hahhen/gbczero/gbczero/gbczero.kicad_pcb

## KiCad design gbczero/gbczero.kicad_pcb (2025-12-26)

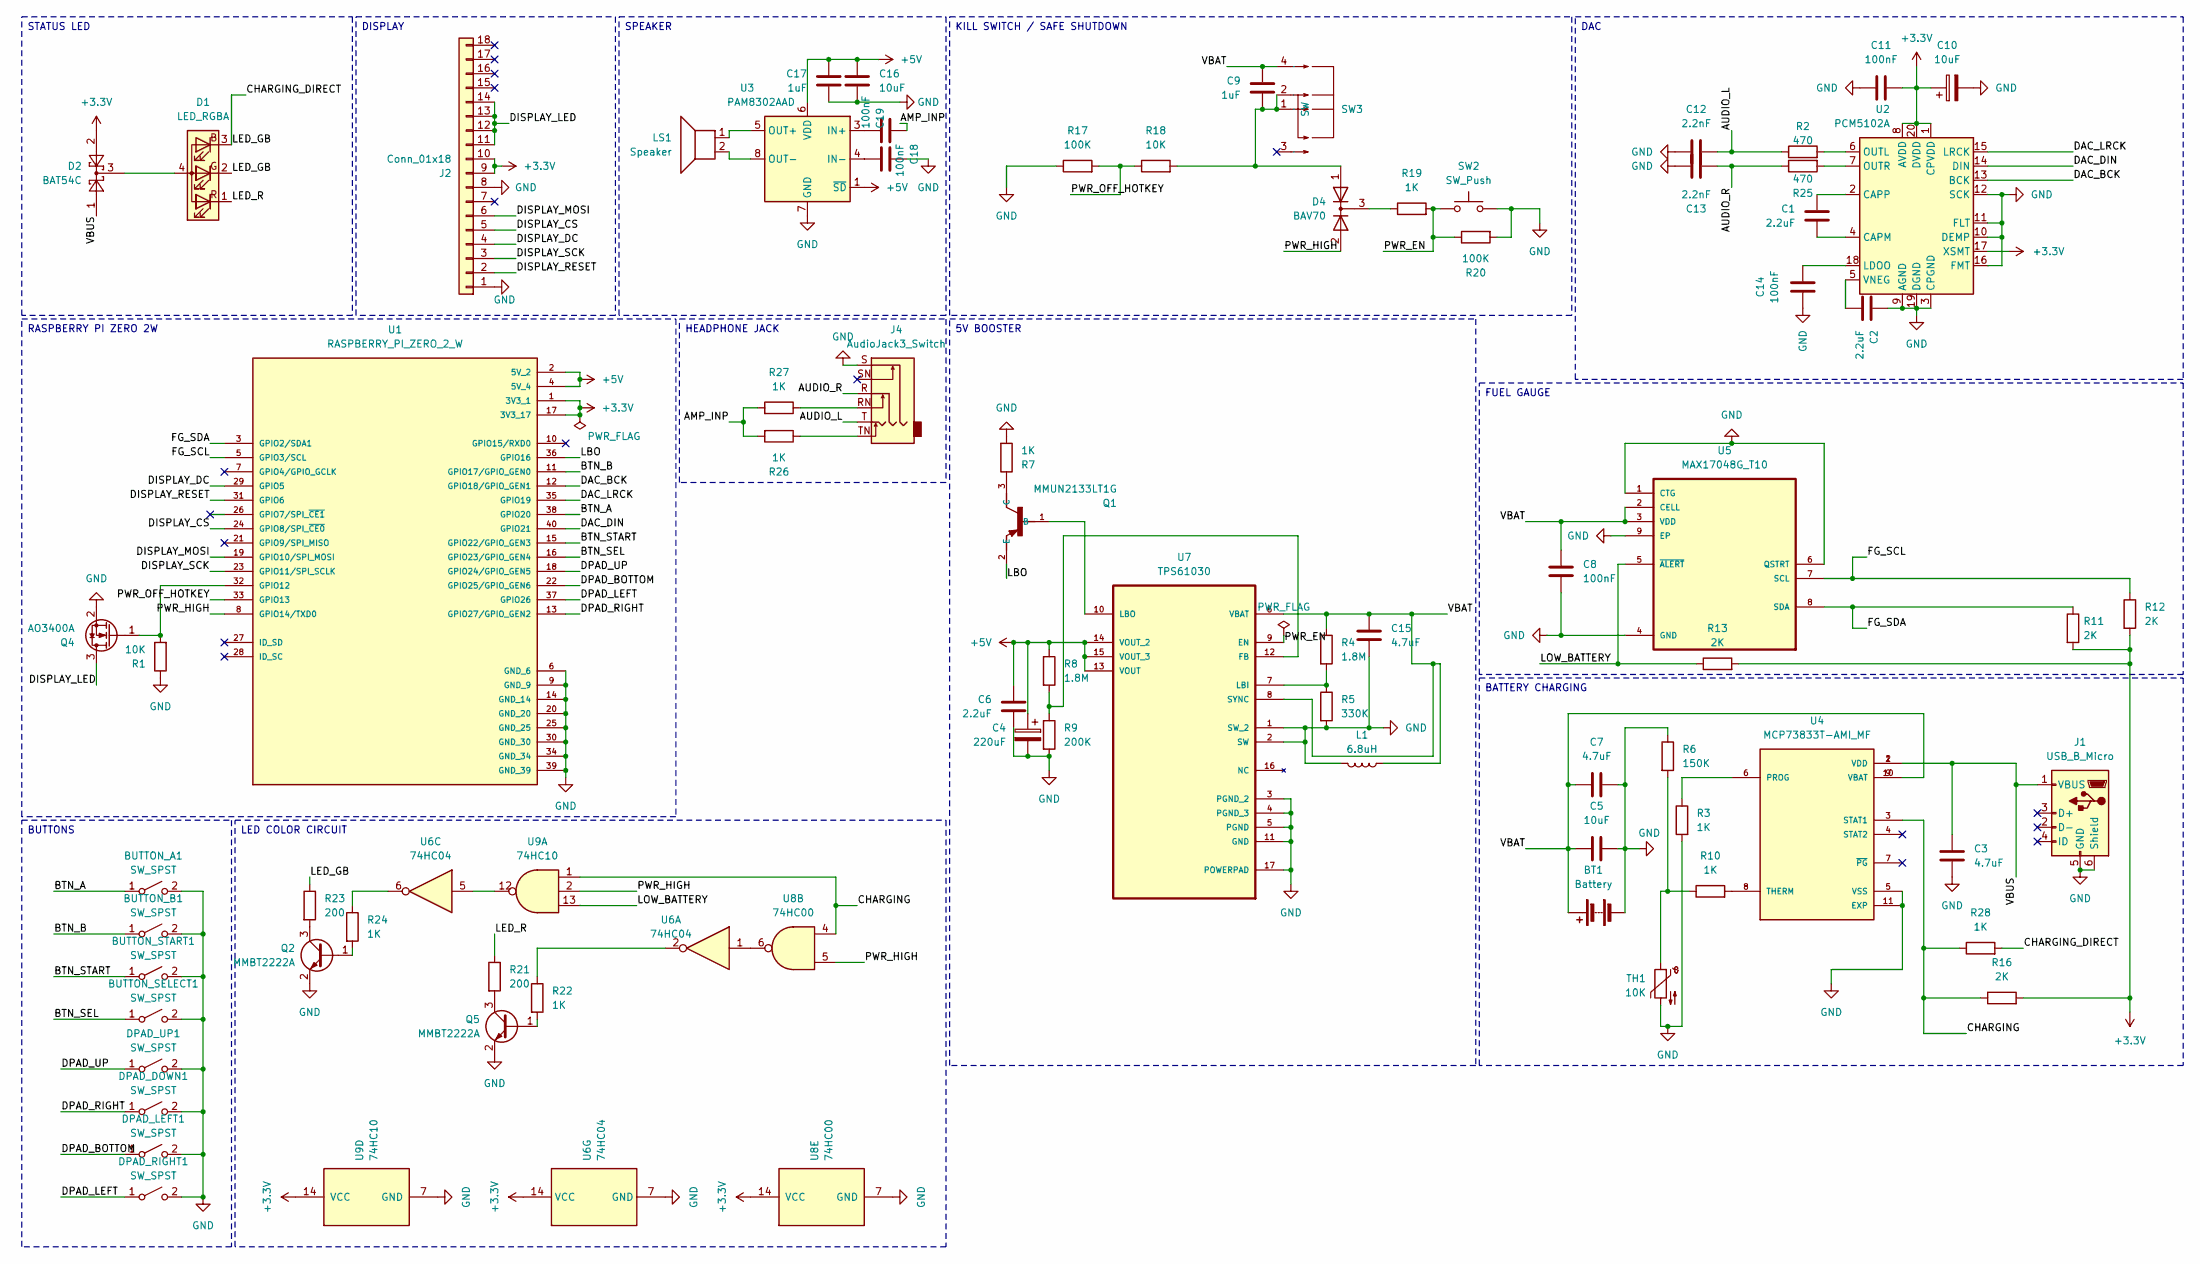
[picture p1: schematic gbczero.kicad_sch, Gameboy Color Zero]

Parts:
BT1: Battery; JST_PH_S2B-PH-K_1x02_P2.00mm_Horizontal
BUTTON_A1: SW_SPST; GameBoy-DMG-BTN
BUTTON_B1: SW_SPST; GameBoy-DMG-BTN
BUTTON_SELECT1: SW_SPST; GameBoy-DMG-START-SEL
BUTTON_START1: SW_SPST; GameBoy-DMG-START-SEL
C1, C2, C6: 2.2uF; C_0603_1608Metric
C3, C7, C15: 4.7uF; C_0603_1608Metric
C4: 220uF; CP_EIA-7343-31_Kemet-D
C5, C16: 10uF; C_0603_1608Metric
C8, C11, C14, C18, C19: 100nF; C_0603_1608Metric
C9, C17: 1uF; C_0603_1608Metric
C10: 10uF; CP_EIA-3216-18_Kemet-A
C12, C13: 2.2nF; C_0603_1608Metric
D1: LED_RGBA; LED_D5.0mm-4_RGB
D2: BAT54C; SOT-23
D4: BAV70; SOT-23
DPAD_DOWN1: SW_SPST; GameBoy-DMG-BTN
DPAD_LEFT1: SW_SPST; GameBoy-DMG-BTN
DPAD_RIGHT1: SW_SPST; GameBoy-DMG-BTN
DPAD_UP1: SW_SPST; GameBoy-DMG-BTN
J1: USB_B_Micro; USB_Micro-B_Molex_47346-0001
J2: Conn_01x18; Hirose_FH12-18S-0.5SH_1x18-1MP_P0.50mm_Horizontal
J4: AudioJack3_Switch; Jack_3.5mm_CUI_SJ1-3523N_Horizontal
L1: 6.8uH; L_6.3x6.3_H3
LS1: Speaker; PinHeader_1x02_P2.54mm_Vertical
Q1: MMUN2133LT1G; SOT95P240X111-3N
Q2, Q5: MMBT2222A; SOT-23
Q4: AO3400A; SOT-23
R1, R18: 10K; R_0603_1608Metric
R2, R25: 470; R_0603_1608Metric
R3, R7, R10, R19, R22, R24, R26, R27, R28: 1K; R_0603_1608Metric
R4, R8: 1.8M; R_0603_1608Metric
R5: 330K; R_0603_1608Metric
R6: 150K; R_0603_1608Metric
R9: 200K; R_0603_1608Metric
R11, R12, R13, R16: 2K; R_0603_1608Metric
R17, R20: 100K; R_0603_1608Metric
R21, R23: 200; R_0603_1608Metric
SW2: SW_Push; SW_Push_1P1T_XKB_TS-1187A
SW3: SW; SW-SMD_4P-P1.50_L3.6-W11.3; Manufacturer Part SK-1391L-2; LCSC Part Name 卧贴双档 滑动开关
TH1: 10K; R_0603_1608Metric
U1: RASPBERRY_PI_ZERO_2_W; MODULE_RASPBERRY_PI_ZERO_2_W; PARTREV April 2024
U2: PCM5102A; TSSOP-20_4.4x6.5mm_P0.65mm
U3: PAM8302AAD; SOIC-8_3.9x4.9mm_P1.27mm
U4: MCP73833T-AMI_MF; SON50P300X300X100-11N
U5: MAX17048G_T10; SON50P200X200X80-9N
U6: 74HC04; SOIC-14_3.9x8.7mm_P1.27mm
U7: TPS61030; SOP65P640X120-17N; MPN TPS61030
U8: 74HC00; SOIC-14_3.9x8.7mm_P1.27mm
U9: 74HC10; SOIC-14_3.9x8.7mm_P1.27mm

Connections:
+3.3V: C10.1, C11.1, D2.2, J2.9, J2.10, R11.2, R12.2, R13.2, R16.2, U1.1 (3V3_1), U1.17 (3V3_17), U2.1 (CPVDD), U2.8 (AVDD), U2.17 (XSMT), U2.20 (DVDD), U6.14 (VCC), U8.14 (VCC), U9.14 (VCC)
+5V: C4.1, C6.1, C16.1, C17.1, R8.1, U1.2 (5V_2), U1.4 (5V_4), U3.1 (~SD), U3.6 (VDD), U7.13 (VOUT), U7.14 (VOUT_2), U7.15 (VOUT_3)
/AMP_INP: C19.1, R26.2, R27.2
/AUDIO_L: C12.1, J4.T, R2.1
/AUDIO_R: C13.1, J4.R, R25.1
/BTN_A: BUTTON_A1.1 (A), U1.38 (GPIO20)
/BTN_B: BUTTON_B1.1 (A), U1.11 (GPIO17/GPIO_GEN0)
/BTN_SEL: BUTTON_SELECT1.1 (A), U1.16 (GPIO23/GPIO_GEN4)
/BTN_START: BUTTON_START1.1 (A), U1.15 (GPIO22/GPIO_GEN3)
/CHARGING: R16.1, R28.1, U4.3 (STAT1), U8.4, U9.1
/CHARGING_DIRECT: D1.2 (GK), D1.3 (BK), R23.1, R28.2
/DAC_BCK: U1.12 (GPIO18/GPIO_GEN1), U2.13 (BCK)
/DAC_DIN: U1.40 (GPIO21), U2.14 (DIN)
/DAC_LRCK: U1.35 (GPIO19), U2.15 (LRCK)
/DISPLAY_CS: J2.5, U1.24 (GPIO8/SPI_~CE0)
/DISPLAY_DC: J2.4, U1.29 (GPIO5)
/DISPLAY_LED: J2.11, J2.12, J2.13, J2.14, Q4.3 (D)
/DISPLAY_MOSI: J2.6, U1.19 (GPIO10/SPI_MOSI)
/DISPLAY_RESET: J2.2, U1.31 (GPIO6)
/DISPLAY_SCK: J2.3, U1.23 (GPIO11/SPI_SCLK)
/DPAD_BOTTOM: DPAD_LEFT1.1 (A), U1.22 (GPIO25/GPIO_GEN6)
/DPAD_LEFT: DPAD_RIGHT1.1 (A), U1.37 (GPIO26)
/DPAD_RIGHT: DPAD_DOWN1.1 (A), U1.13 (GPIO27/GPIO_GEN2)
/DPAD_UP: DPAD_UP1.1 (A), U1.18 (GPIO24/GPIO_GEN5)
/FG_SCL: R12.1, U1.5 (GPIO3/SCL), U5.7 (SCL)
/FG_SDA: R11.1, U1.3 (GPIO2/SDA1), U5.8 (SDA)
/LBO: Q1.2 (E), U1.36 (GPIO16)
/LED_R: D1.1 (RK), R21.1
/LOW_BATTERY: R13.1, U5.5 (~ALERT), U9.13
/PWR_EN: R19.2, R20.1, SW2.1, U7.9 (EN)
/PWR_HIGH: D4.2 (A), U1.8 (GPIO14/TXD0), U8.5, U9.2
/PWR_OFF_HOTKEY: R17.2, R18.1, U1.33 (GPIO13)
/VBAT: BT1.1 (+), C5.2, C7.2, C8.1, C9.1, C15.1, L1.1, R4.1, SW3.4, U4.9 (VBAT), U4.10 (VBAT), U5.2 (CELL), U5.3 (VDD), U7.6 (VBAT), U7.8 (SYNC)
/VBUS: C3.1, D2.1, J1.1 (VBUS), U4.1 (VDD), U4.2 (VDD)
GND: BT1.2 (-), BUTTON_A1.2 (B), BUTTON_B1.2 (B), BUTTON_SELECT1.2 (B), BUTTON_START1.2 (B), C2.1, C3.2, C4.2, C5.1, C6.2, C7.1, C8.2, C10.2, C11.2, C12.2, C13.2, C14.2, C15.2, C16.2, C17.2, C18.1, DPAD_DOWN1.2 (B), DPAD_LEFT1.2 (B), DPAD_RIGHT1.2 (B), DPAD_UP1.2 (B), J1.5 (GND), J1.6 (Shield), J2.1, J2.8, J4.S, L1.2, Q2.2 (E), Q4.2 (S), Q5.2 (E), R1.1, R3.2, R5.2, R6.1, R7.2, R9.2, R17.1, R20.2, SW2.2, TH1.2, U1.6 (GND_6), U1.9 (GND_9), U1.14 (GND_14), U1.20 (GND_20), U1.25 (GND_25), U1.30 (GND_30), U1.34 (GND_34), U1.39 (GND_39), U2.3 (CPGND), U2.9 (AGND), U2.10 (DEMP), U2.11 (FLT), U2.12 (SCK), U2.16 (FMT), U2.19 (DGND), U3.7 (GND), U4.5 (VSS), U4.11 (EXP), U5.1 (CTG), U5.4 (GND), U5.6 (QSTRT), U5.9 (EP), U6.7 (GND), U7.1 (SW_2), U7.2 (SW), U7.3 (PGND_2), U7.4 (PGND_3), U7.5 (PGND), U7.11 (GND), U7.17 (POWERPAD), U8.7 (GND), U9.7 (GND)
unnamed: C9.2, D4.1 (A), R18.2, SW3.1, SW3.2
unnamed: D1.4 (A), D2.3
unnamed: D4.3 (K), R19.1
unnamed: J4.RN, R27.1
unnamed: J4.TN, R26.1
unnamed: Q1.1 (B), U7.10 (LBO)
unnamed: Q1.3 (C), R7.1
unnamed: Q2.1 (B), R24.2
unnamed: Q2.3 (C), R23.2
unnamed: Q4.1 (G), R1.2, U1.32 (GPIO12)
unnamed: Q5.1 (B), R22.2
unnamed: Q5.3 (C), R21.2
unnamed: R6.2, R10.1, TH1.1
unnamed: R22.1, U6.2
unnamed: R24.1, U6.6
unnamed: C1.2, U2.4 (CAPM)
unnamed: C1.1, U2.2 (CAPP)
unnamed: C14.1, U2.18 (LDOO)
unnamed: R2.2, U2.6 (OUTL)
unnamed: R25.2, U2.7 (OUTR)
unnamed: C2.2, U2.5 (VNEG)
unnamed: C19.2, U3.3 (IN+)
unnamed: C18.2, U3.4 (IN-)
unnamed: LS1.1, U3.5 (OUT+)
unnamed: LS1.2, U3.8 (OUT-)
unnamed: R3.1, U4.6 (PROG)
unnamed: R10.2, U4.8 (THERM)
unnamed: U6.1, U8.6
unnamed: U6.5, U9.12
unnamed: R8.2, R9.1, U7.12 (FB)
unnamed: R4.2, R5.1, U7.7 (LBI)

Notes on the sheet:
BATTERY CHARGING
FUEL GAUGE
SPEAKER
BUTTONS
RASPBERRY PI ZERO 2W
DAC
5V BOOSTER
HEADPHONE JACK
STATUS LED
KILL SWITCH / SAFE SHUTDOWN
LED COLOR CIRCUIT
DISPLAY

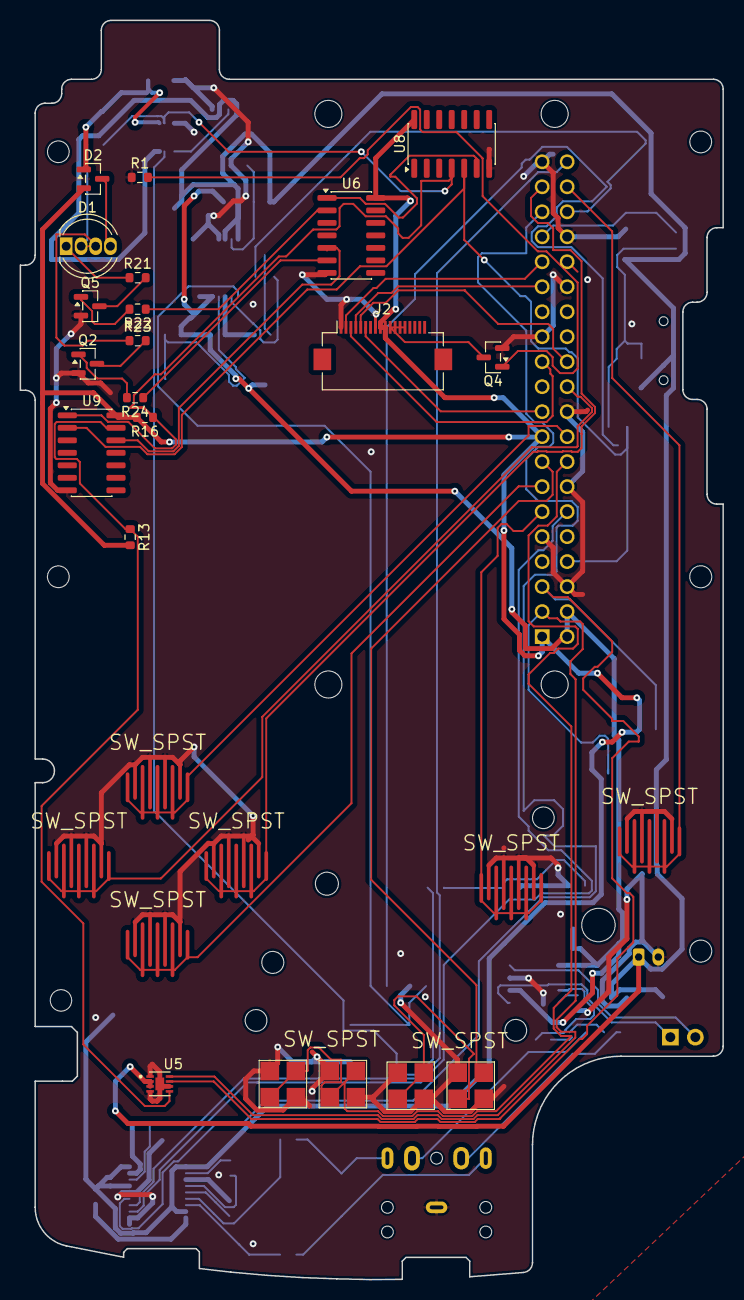
[picture p2: board gbczero.kicad_pcb from above]

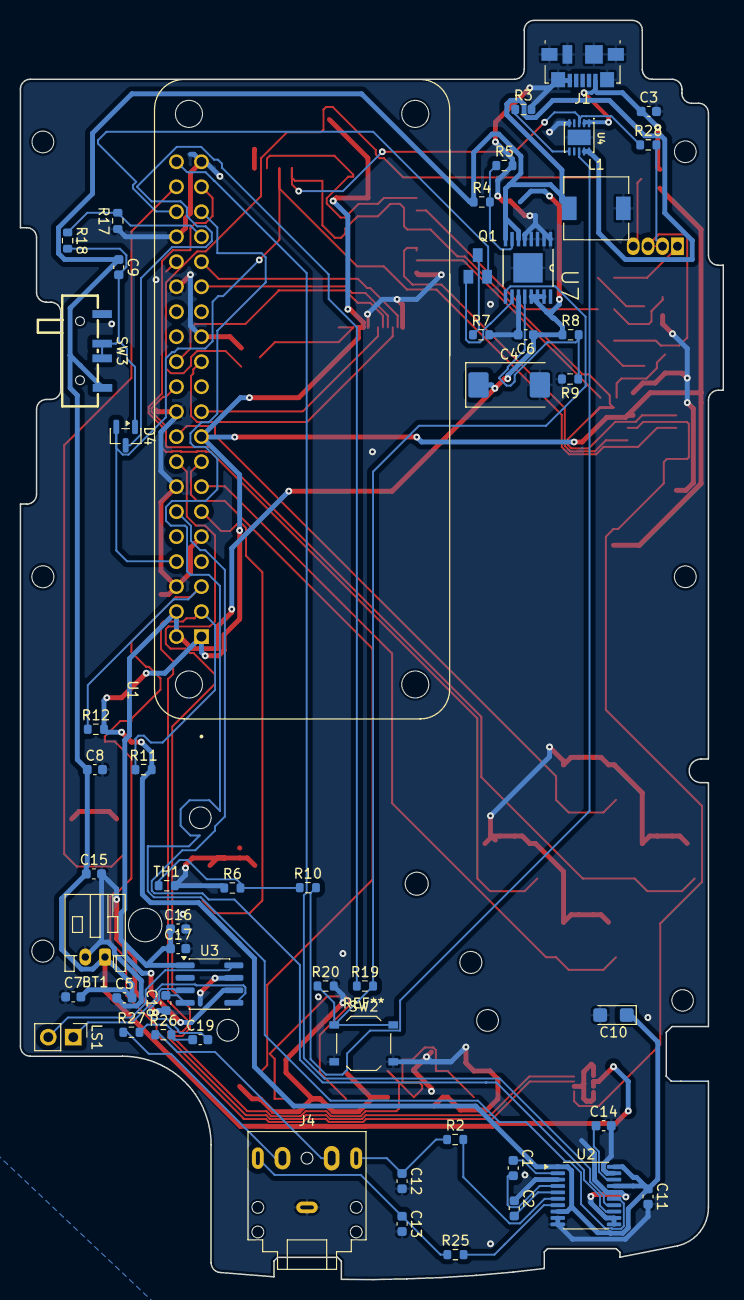
[picture p3: board gbczero.kicad_pcb from below]

Board: 2 copper layers, 71.4 x 128.0 mm, 78 parts (53 on the bottom side), 66 nets.
