hahhen/gbczero/(commit log)

2025-11-20 First iteration
    [gbczero.kicad_pcb, gbczero.kicad_sch]
2025-12-25 almost done
    [gbczero.kicad_pcb, gbczero.kicad_sch]
2025-12-25 zero errors
    [gbczero.kicad_pcb, gbczero.kicad_sch]
2025-12-26 Finished (maybe)
    [bom.csv, designators.csv, gbczero.kicad_pcb, gbczero.kicad_sch, positions.csv]
2025-12-29 I'll change some things in a bit
    [gbczero.kicad_sch]
